FREILab/RFID-Box/hardware/PCB/3D-models/Female2.54MM1x15.step

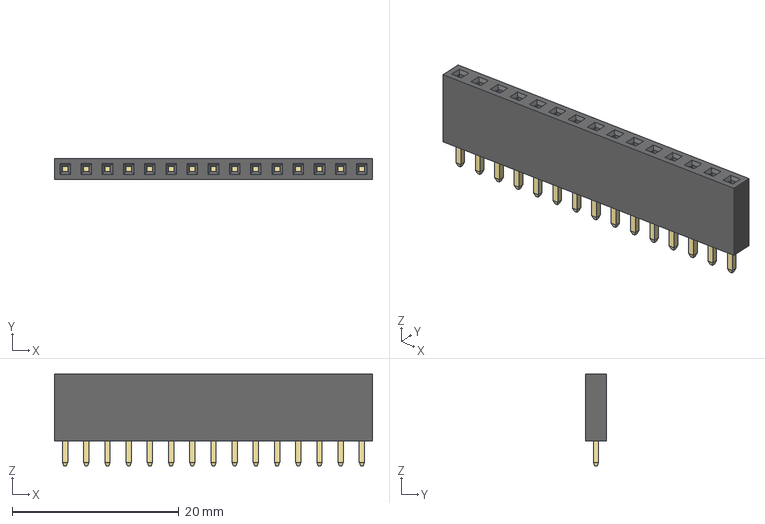
[picture p3: CAD file, 2025-02-08]
hardware/PCB/3D-models/Female2.54MM1x15.step
38.1 x 2.54 x 11.0 mm
