FREILab/RFID-Box/hardware/PCB/3D-models/TBA_2-2411.step

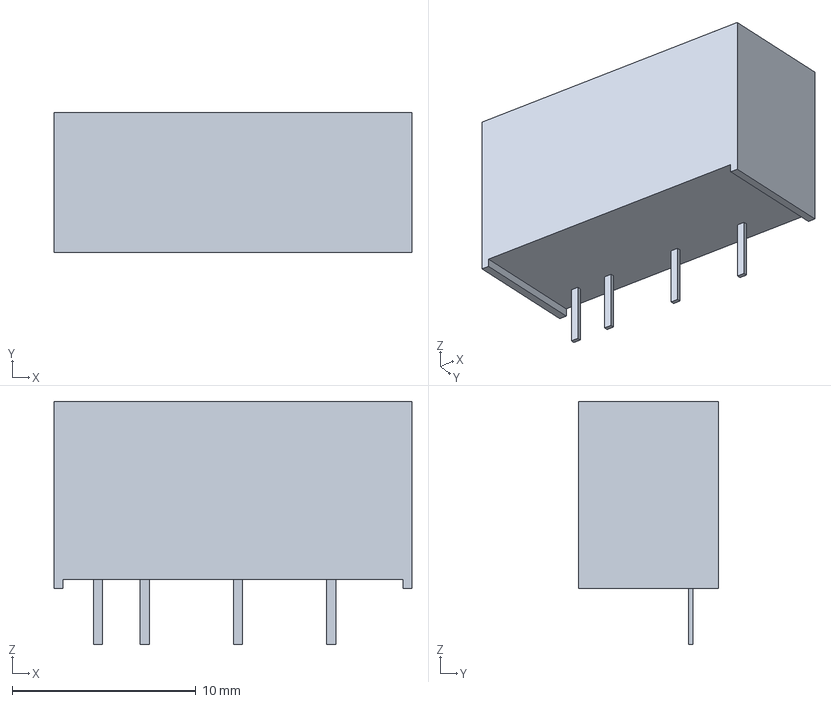
[picture p4: CAD file, 2025-02-08]
hardware/PCB/3D-models/TBA_2-2411.step
19.5 x 7.60 x 13.2 mm
